RenewableEnergyNexus/ownverter/KiCAD_files/High_side.kicad_sch

## KiCad design KiCAD_files/High_side.kicad_sch (2024-07-12)

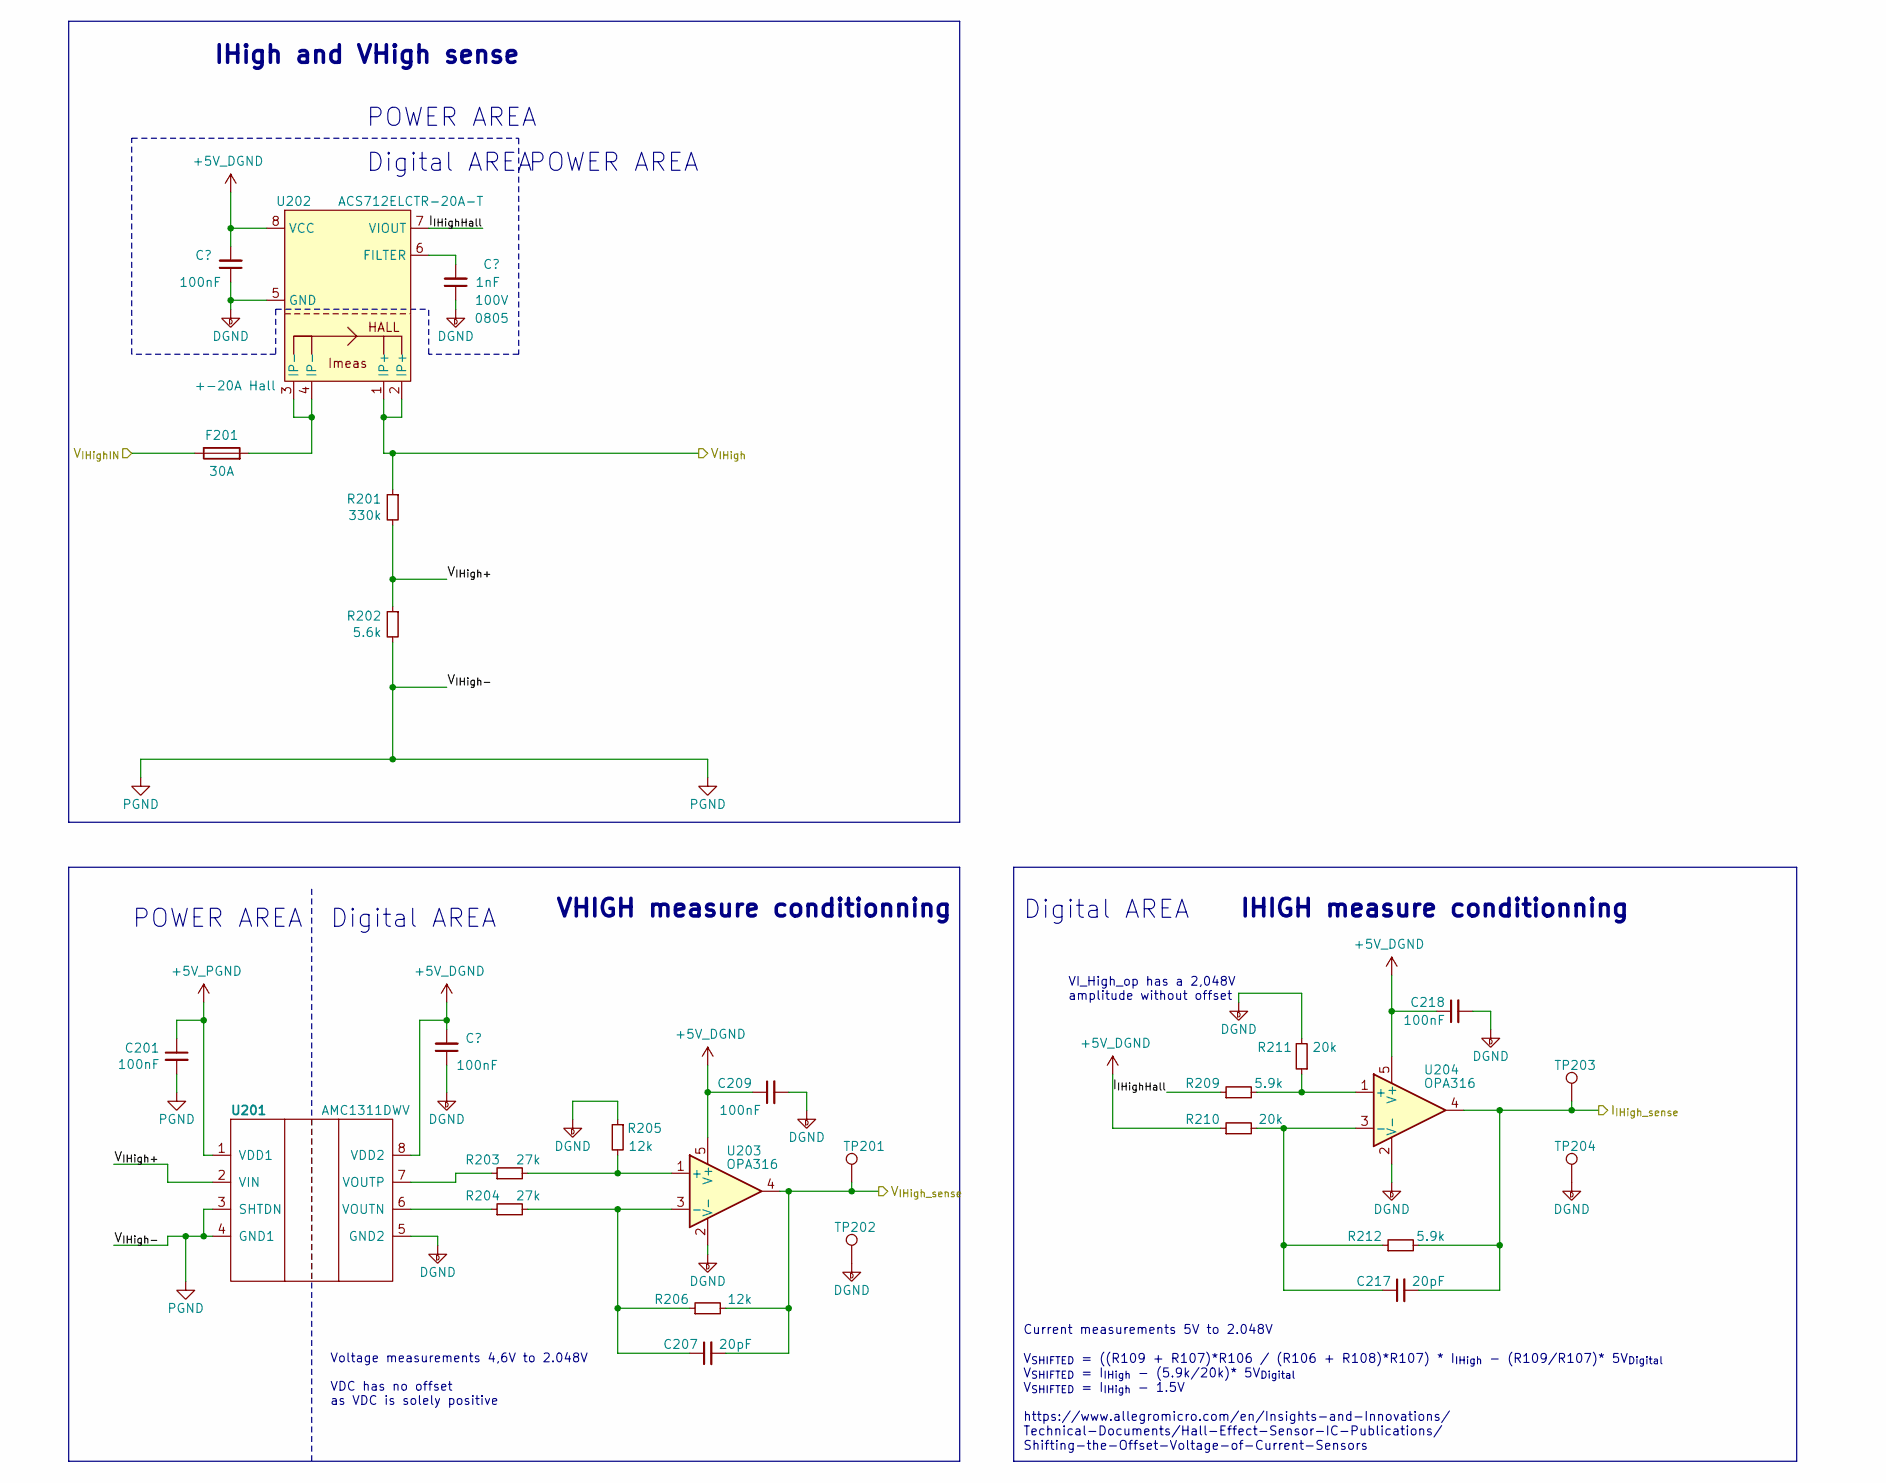
[picture p3: schematic High_side.kicad_sch]

Parts:
C201, C209, C218: 100nF; C_0805_2012Metric
C202, C203: 100nF; C_0805_2012Metric; Voltage 50V
C204: 1nF; C_0805_2012Metric; Voltage 100V
C207, C217: 20pF; C_0805_2012Metric
F201: 30A; F_0678H_Bel
R201: 330k; R_0805_2012Metric
R202: 5.6k; R_0805_2012Metric
R203, R204: 27k; R_0805_2012Metric
R205, R206: 12k; R_0805_2012Metric
R209, R212: 5.9k; R_0805_2012Metric
R210, R211: 20k; R_0805_2012Metric
TP201, TP202, TP203, TP204: TestPoint; TestPoint_THTPad_D1.5mm_Drill0.7mm
U201: AMC1311DWV; SOIC-8_7.5x5.85mm_P1.27mm
U202: +-20A Hall; SOIC-8_3.9x4.9mm_P1.27mm
U203, U204: OPA316; SOT-353_SC-70-5

Connections:
+5V_DGND: C202.2, C203.2, C209.1, C218.1, R210.1, U201.8 (VDD2), U202.8 (VCC), U203.5 (V+), U204.5 (V+)
+5V_PGND: C201.1, U201.1 (VDD1)
DGND: C202.1, C203.1, C204.1, C209.2, C218.2, R205.1, R211.2, TP202.1, TP204.1, U201.5 (GND2), U202.5 (GND), U203.2 (V-), U204.2 (V-)
I_{IHighHall}: R209.1, U202.7 (VIOUT)
I_{IHigh_sense}: C217.2, R212.2, TP203.1, U204.4
unnamed: C204.2, U202.6 (FILTER)
unnamed: C207.1, R204.2, R206.1, U203.3 (-)
unnamed: C217.1, R210.2, R212.1, U204.3 (-)
unnamed: F201.2, U202.3 (IP-), U202.4 (IP-)
unnamed: R203.1, U201.7 (VOUTP)
unnamed: R203.2, R205.2, U203.1 (+)
unnamed: R204.1, U201.6 (VOUTN)
unnamed: R209.2, R211.1, U204.1 (+)
PGND: C201.2, R202.2, U201.3 (SHTDN), U201.4 (GND1)
V_{IHigh+}: R201.2, R202.1, U201.2 (VIN)
V_{IHighIN}: F201.1
V_{IHigh_sense}: C207.2, R206.2, TP201.1, U203.4
V_{IHigh}: R201.1, U202.1 (IP+), U202.2 (IP+)

Notes on the sheet:
Digital AREA
IHIGH measure conditionning
IHigh and VHigh sense
POWER AREA
VI_High_op has a 2,048V amplitude without offset
Voltage measurements 4,6V to 2.048V VDC has no offset as VDC is solely positive
Current measurements 5V to 2.048V V_{SHIFTED} = ((R109 + R107)*R106 / (R106 + R108)*R107) * I_{IHigh} - (R109/R107)* 5V_{Digital} V_{SHIFTED} = I_{IHigh} - (5.9k/20k)* 5V_{Digital} V_{SHIFTED} = I_{IHigh} - 1.5V https://www.allegromicro.com/en/Insights-and-Innovations/ Technical-Documents/Hall-Effe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
VHIGH measure conditionning
