RenewableEnergyNexus/ownverter/KiCAD_files/InverterLeg.kicad_sch

## KiCad design KiCAD_files/InverterLeg.kicad_sch (2024-07-12)

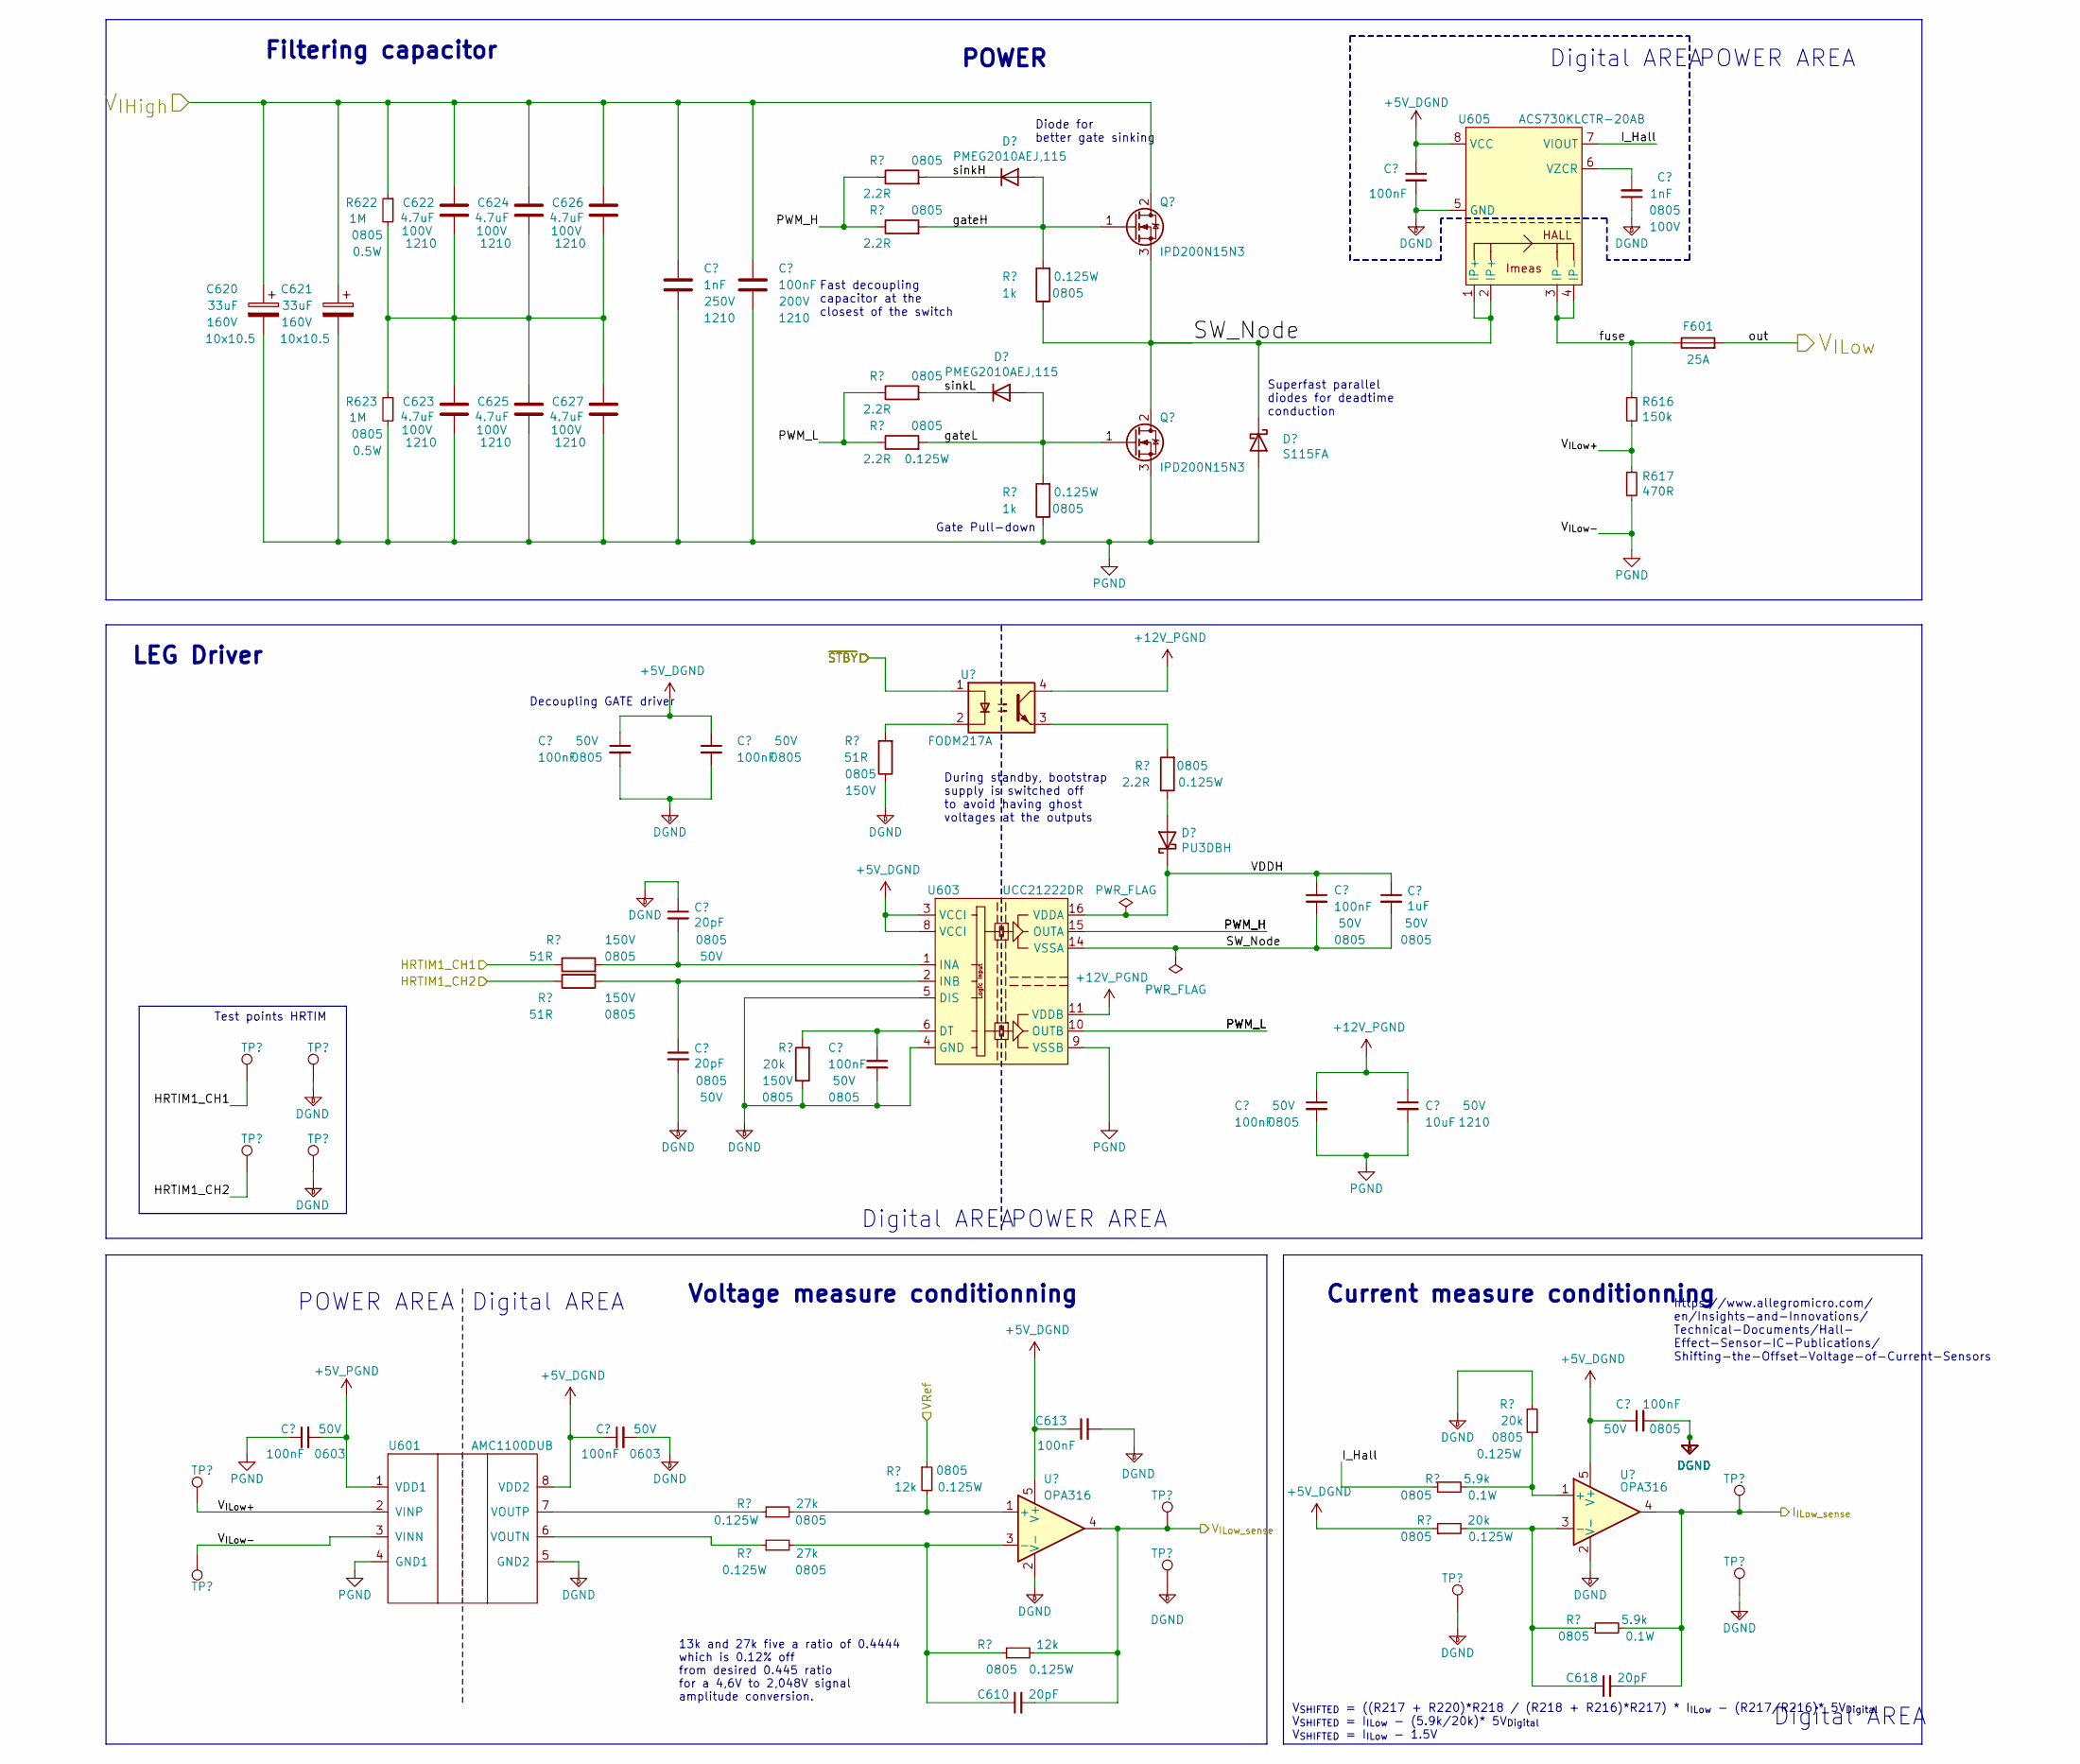
[picture p4: schematic InverterLeg.kicad_sch]

Parts:
C610, C618: 20pF; C_0805_2012Metric
C613: 100nF; C_0805_2012Metric
C620, C621: 33uF; CP_Elec_10x10.5; Voltage 160V
C622, C623, C624, C625, C626, C627: 4.7uF; C_1210_3225Metric; Voltage 100V
C701, C702, C705, C706, C707, C711, C712, C714, C719: 100nF; C_0805_2012Metric; Voltage 50V
C703, C704: 20pF; C_0805_2012Metric; Voltage 50V
C708: 1nF; C_0805_2012Metric; Voltage 250V
C709: 100nF; C_1210_3225Metric; Voltage 200V
C715: 1uF; C_0805_2012Metric; Voltage 50V
C716: 10uF; C_1210_3225Metric; Voltage 50V
C717: 1nF; C_0805_2012Metric; Voltage 100V
D701, D702: PMEG2010AEJ,115; D_SOD-323_HandSoldering
D704: S115FA; D_SOD-123
D705: PU3DBH; D_SMB
F601: 25A; F_0678H_Bel
Q701, Q702: IPD200N15N3; TO-252-2
R616: 150k; R_0805_2012Metric
R617: 470R; R_0805_2012Metric
R622, R623: 1M; R_0805_2012Metric
R701, R702, R703, R704, R714: 2.2R; R_0805_2012Metric
R705, R706, R710: 51R; R_0805_2012Metric; Voltage 150V
R707, R708: 1k; R_0805_2012Metric
R709: 20k; R_0805_2012Metric; Voltage 150V
R711, R712: 27k; R_0805_2012Metric
R713, R715: 12k; R_0805_2012Metric
R718, R721: 5.9k; R_0805_2012Metric
R719, R720: 20k; R_0805_2012Metric
TP701, TP702, TP703, TP712, TP713, TP716, TP717: TestPoint; TestPoint_THTPad_D1.5mm_Drill0.7mm
TP704, TP705, TP706, TP707: TestPoint; TestPoint_Pad_D1.0mm
U601: AMC1100DUB; SOP-8_6.62x9.15mm_P2.54mm
U603: UCC21222DR; SOIC-16_3.9x9.9mm_P1.27mm
U605: ACS730KLCTR-20AB; SOIC-8_3.9x4.9mm_P1.27mm
U702: FODM217A; SO-4_4.4x2.3mm_P1.27mm
U704, U706: OPA316; SOT-353_SC-70-5

Connections:
+5V_DGND: C613.1, C702.1, C705.1, C706.1, C711.1, C719.1, R719.1, U601.8 (VDD2), U603.3 (VCCI), U603.8 (VCCI), U605.8 (VCC), U704.5 (V+), U706.5 (V+)
+5V_PGND: C701.2, U601.1 (VDD1)
+12V_PGND: C714.1, C716.1, U603.11 (VDDB), U702.4
DGND: C613.2, C702.2, C703.1, C704.2, C705.2, C706.2, C707.2, C711.2, C717.1, C719.2, R709.1, R710.1, R720.2, TP703.1, TP706.1, TP707.1, TP713.1, TP717.1, U601.5 (GND2), U603.4 (GND), U603.5 (DIS), U605.5 (GND), U704.2 (V-), U706.2 (V-)
HRTIM1_CH1: R705.1, TP704.1
HRTIM1_CH2: R706.1, TP705.1
I_Hall: R718.1, U605.7 (VIOUT)
I_{ILow_sense}: C618.2, R721.2, TP716.1, U706.4
unnamed: C610.1, R712.2, R715.1, U704.3 (-)
unnamed: C618.1, R719.2, R721.1, U706.3 (-)
unnamed: C622.2, C623.1, C624.2, C625.1, C626.2, C627.1, R622.2, R623.1
unnamed: C703.2, R705.2, U603.1 (INA)
unnamed: C704.1, R706.2, U603.2 (INB)
unnamed: C707.1, R709.2, U603.6 (DT)
unnamed: C717.2, U605.6 (VZCR)
unnamed: D705.2 (A), R714.1
unnamed: R710.2, U702.2
unnamed: R711.1, U601.7 (VOUTP)
unnamed: R711.2, R713.2, U704.1 (+)
unnamed: R712.1, U601.6 (VOUTN)
unnamed: R714.2, U702.3
unnamed: R718.2, R720.1, U706.1 (+)
PGND: C620.2, C621.2, C623.2, C625.2, C627.2, C701.1, C708.2, C709.2, C714.2, C716.2, D704.2 (A), Q702.3 (S), R617.2, R623.2, R708.1, TP702.1, U601.3 (VINN), U601.4 (GND1), U603.9 (VSSB)
PWM_H: R701.1, R702.1, U603.15 (OUTA)
PWM_L: R703.1, R704.1, U603.10 (OUTB)
SW_Node: C712.2, C715.2, D704.1 (K), Q701.3 (S), Q702.2 (D), R707.1, U603.14 (VSSA), U605.1 (IP+), U605.2 (IP+)
VDDH: C712.1, C715.1, D705.1 (K), U603.16 (VDDA)
VRef: R713.1
V_{IHigh}: C620.1, C621.1, C622.1, C624.1, C626.1, C708.1, C709.1, Q701.2 (D), R622.1
V_{ILow+}: R616.2, R617.1, TP701.1, U601.2 (VINP)
V_{ILow_sense}: C610.2, R715.2, TP712.1, U704.4
fuse: F601.1, R616.1, U605.3 (IP-), U605.4 (IP-)
gateH: D702.2 (A), Q701.1 (G), R702.2, R707.2
gateL: D701.2 (A), Q702.1 (G), R704.2, R708.2
out: F601.2
sinkH: D702.1 (K), R701.2
sinkL: D701.1 (K), R703.2
~STBY: U702.1

Notes on the sheet:
Filtering capacitor
https://www.allegromicro.com/ en/Insights-and-Innovations/ Technical-Documents/Hall- Effect-Sensor-IC-Publications/ Shifting-the-Offset-Voltage-of-Current-Sensors
LEG Driver
Digital AREA
POWER AREA
Diode for better gate sinking
Test points HRTIM
POWER
Current measure conditionning
Voltage measure conditionning
During standby, bootstrap supply is switched off to avoid having ghost voltages at the outputs
13k and 27k five a ratio of 0.4444 which is 0.12% off from desired 0.445 ratio for a 4,6V to 2,048V signal amplitude conversion.
Gate Pull-down
Superfast parallel diodes for deadtime conduction
V_{SHIFTED} = ((R217 + R220)*R218 / (R218 + R216)*R217) * I_{ILow} - (R217/R216)* 5V_{Digital} V_{SHIFTED} = I_{ILow} - (5.9k/20k)* 5V_{Digital} V_{SHIFTED} = I_{ILow} - 1.5V
Decoupling GATE driver
Fast decoupling capacitor at the closest of the switch
