RenewableEnergyNexus/ownverter/KiCAD_files/inverter.kicad_sch

## KiCad design KiCAD_files/inverter.kicad_sch (2024-07-12)

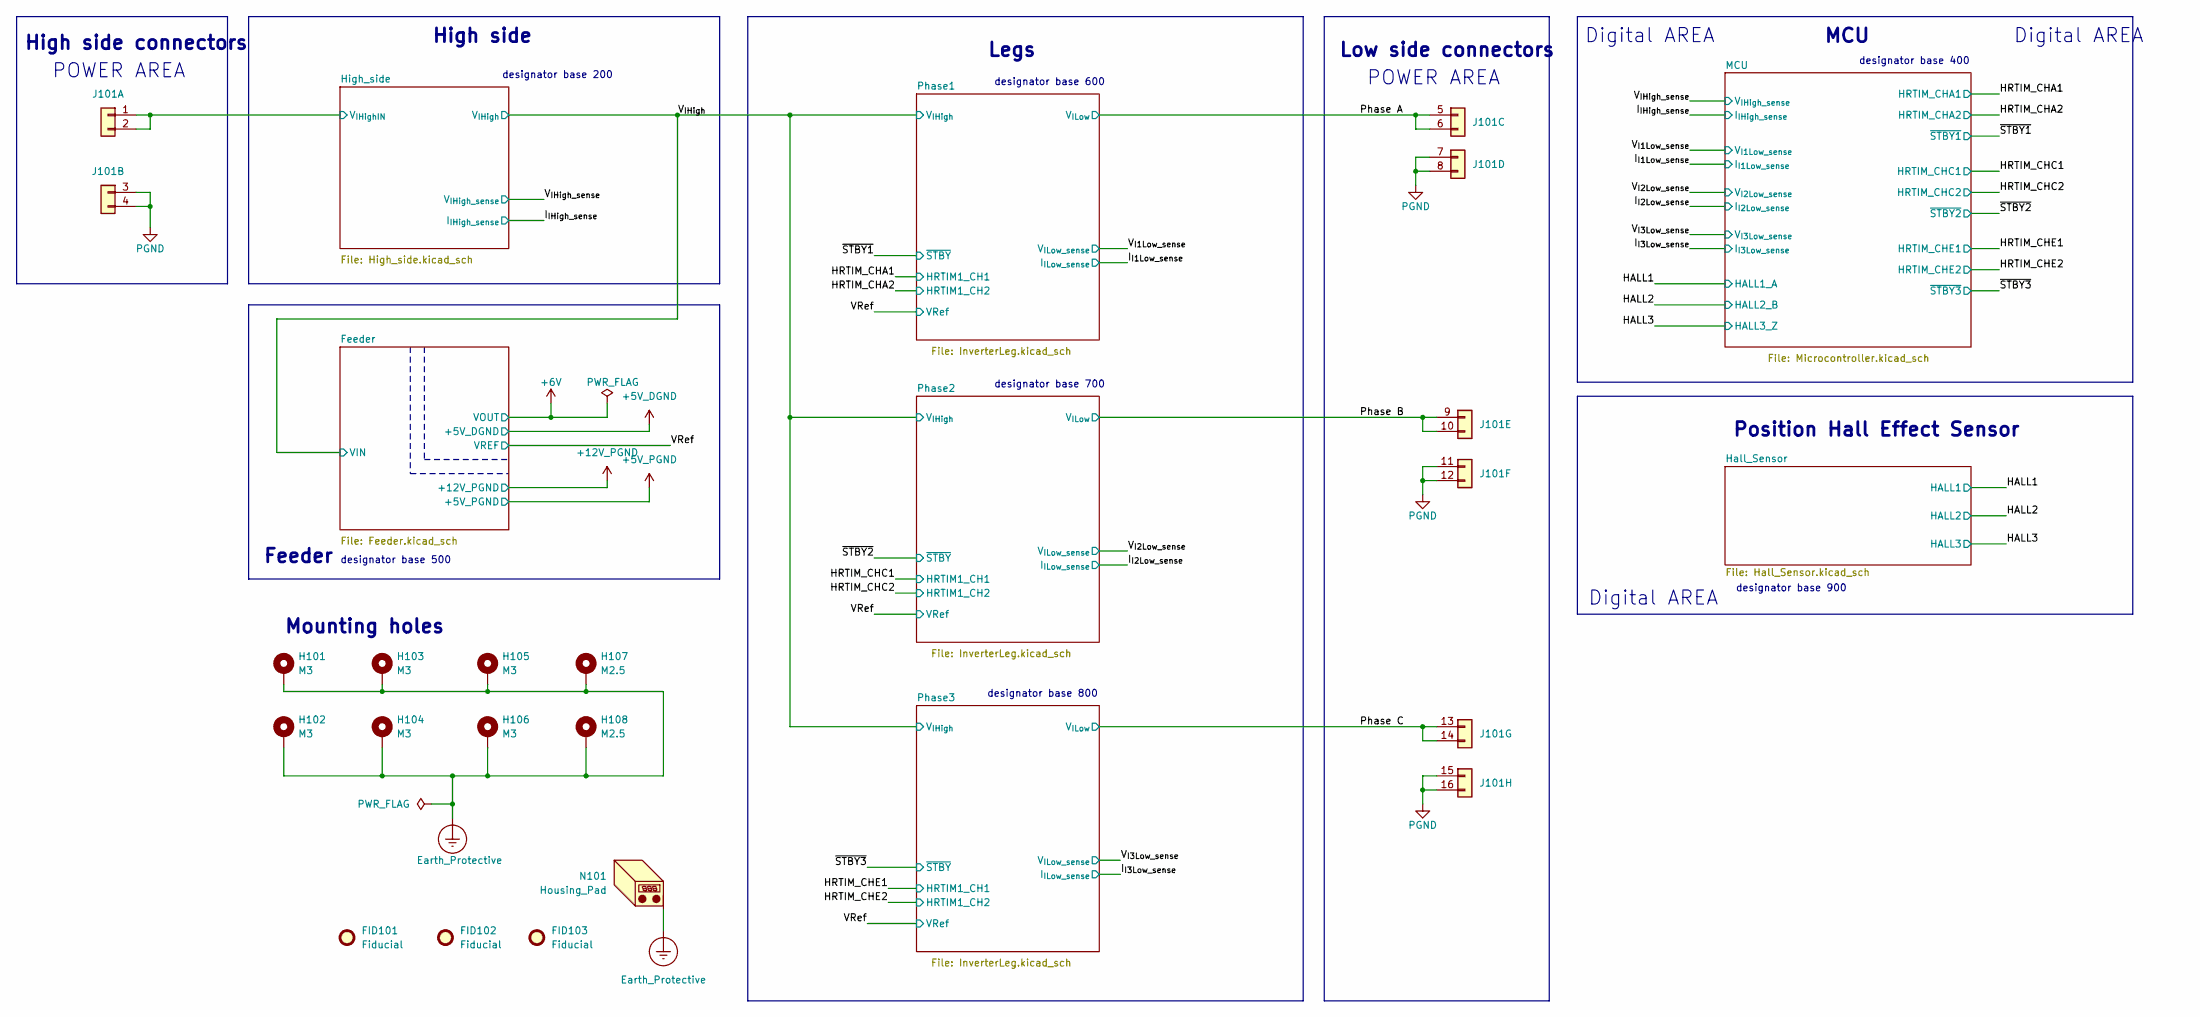
[picture p6: schematic inverter.kicad_sch]

Parts:
FID101, FID102, FID103: Fiducial; Fiducial_0.75mm_Mask1.5mm
H101, H102, H103, H104, H105, H106: M3; MountingHole_3.2mm_M3_DIN965_Pad_TopOnly
H107: M2.5; MountingHole_2.7mm_M2.5_DIN965_Pad_TopOnly
H108: M2.5; MountingHole_2.7mm_M2.5_ISO7380_Pad_TopOnly
J101: Harting-15 and Wago 6; Harting - 15contacts and Wago
N101: Housing_Pad; Guard_ring

Connections:
Earth_Protective: H101.1, H102.1, H103.1, H104.1, H105.1, H106.1, H107.1, H108.1, N101.1
PGND: J101.3 (Pin_1), J101.4 (Pin_2), J101.7 (Pin_1), J101.8 (Pin_2), J101.11 (Pin_1), J101.12 (Pin_2), J101.15 (Pin_1), J101.16 (Pin_2)
Phase A: J101.5 (Pin_1), J101.6 (Pin_2)
Phase B: J101.9 (Pin_1), J101.10 (Pin_2)
Phase C: J101.13 (Pin_1), J101.14 (Pin_2)
V_{IHighIN}: J101.1, J101.2

Notes on the sheet:
MCU
Digital AREA
High side
designator base 600
designator base 700
Legs
Feeder
designator base 800
POWER AREA
designator base 200
Mounting holes
Position Hall Effect Sensor
designator base 400
designator base 900
High side connectors
designator base 500
Low side connectors
