RenewableEnergyNexus/ownverter/KiCAD_files/ownverter.kicad_sch

## KiCad design KiCAD_files/ownverter.kicad_sch (2023-11-14)

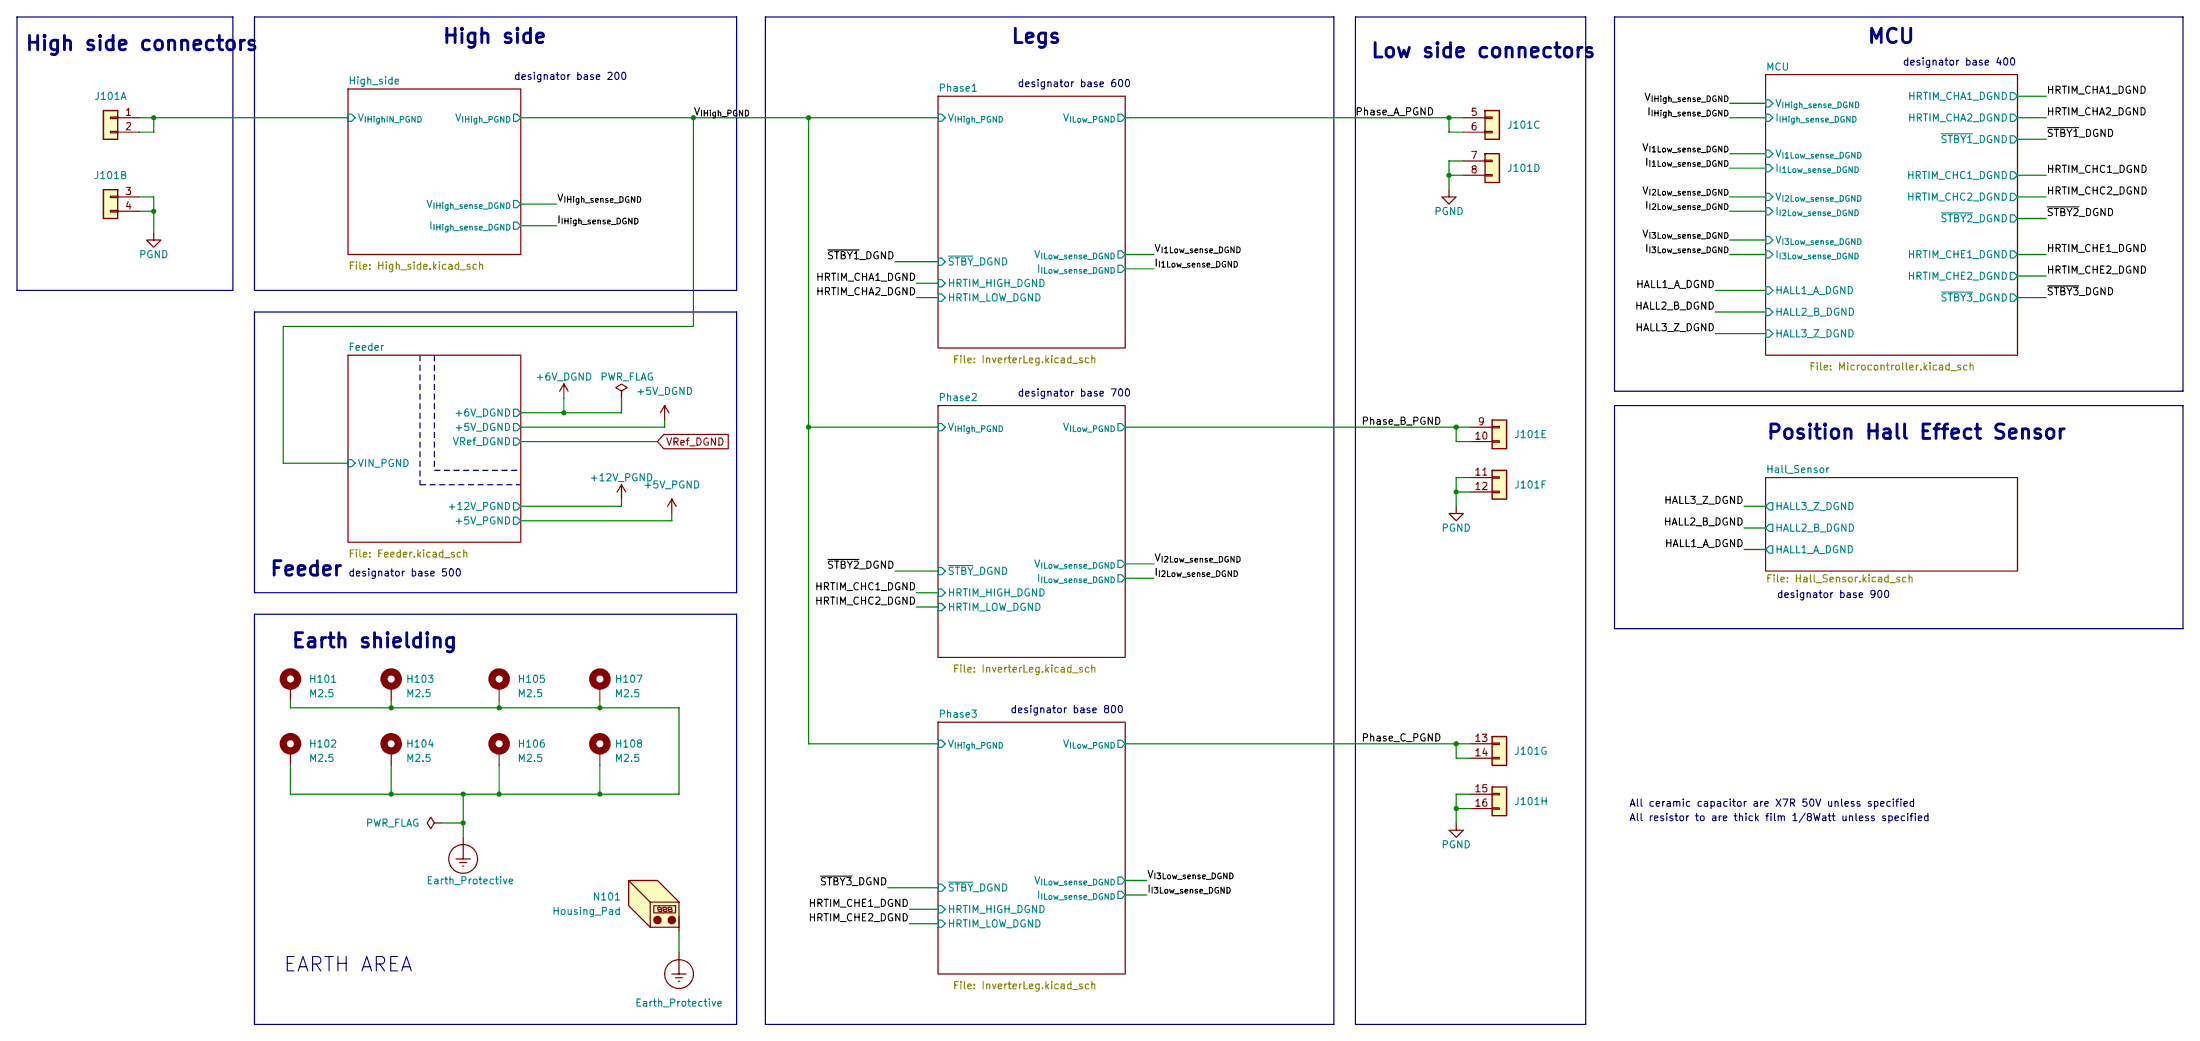
[picture p7: schematic ownverter.kicad_sch]

Parts:
H101, H102, H103, H104, H105, H106, H107, H108: M2.5; MountingHole_2.7mm_M2.5_DIN965_Pad_TopOnly
J101: Harting-15 and Wago 6; Harting - 15contacts and Wago
N101: Housing_Pad; Guard_ring

Connections:
Earth_Protective: H101.1, H102.1, H103.1, H104.1, H105.1, H106.1, H107.1, H108.1, N101.1
PGND: J101.3 (Pin_1), J101.4 (Pin_2), J101.7 (Pin_1), J101.8 (Pin_2), J101.11 (Pin_1), J101.12 (Pin_2), J101.15 (Pin_1), J101.16 (Pin_2)
Phase_A_PGND: J101.5 (Pin_1), J101.6 (Pin_2)
Phase_B_PGND: J101.9 (Pin_1), J101.10 (Pin_2)
Phase_C_PGND: J101.13 (Pin_1), J101.14 (Pin_2)
V_{IHighIN_PGND}: J101.1, J101.2

Notes on the sheet:
All ceramic capacitor are X7R 50V unless specified
MCU
High side
designator base 600
designator base 700
Legs
EARTH AREA
Feeder
designator base 800
designator base 200
Earth shielding
All resistor to are thick film 1/8Watt unless specified
Position Hall Effect Sensor
designator base 400
designator base 900
High side connectors
designator base 500
Low side connectors
