RenewableEnergyNexus/ownverter/(commit log)

2023-11-14 revert previous commit
    [ownverter.kicad_sch]
2023-11-14 corrected version number in template
    [Feeder.kicad_sch, Hall_Sensor.kicad_sch, High_side.kicad_sch, InverterLeg.kicad_sch, Microcontroller.kicad_sch, ownverter.kicad_sch]
2024-07-12 Added ERC rules for galvanic isolation. Modified SPIN pinout.
    [Feeder.kicad_sch, Hall_Sensor.kicad_sch, High_side.kicad_sch, InverterLeg.kicad_sch, Microcontroller.kicad_sch, inverter.kicad_sch]
